Tjuur/G2P2_pochoco_soc/asic/reports/layout/pin_coordinates.csv

pin | direction | use | x_um | y_um | orientation
VDD | INOUT | POWER | 484.96 | 951.41 | N
VSS | INOUT | GROUND | 484.96 | 954.71 | N
i_Clk | INPUT | SIGNAL | 970.045 | 27.16 | N
i_Reset_n | INPUT | SIGNAL | 892.92 | 987.965 | N
i_SPI_CS_n | INPUT | SIGNAL | 970.045 | 675.64 | N
i_SPI_MOSI | INPUT | SIGNAL | 970.045 | 663.32 | N
i_SPI_SCLK | INPUT | SIGNAL | 970.045 | 676.76 | N
i_Switch[0] | INPUT | SIGNAL | 970.045 | 625.24 | N
i_Switch[1] | INPUT | SIGNAL | 970.045 | 631.96 | N
i_Switch[2] | INPUT | SIGNAL | 970.045 | 630.84 | N
i_Switch[3] | INPUT | SIGNAL | 970.045 | 609.56 | N
o_LED[0] | OUTPUT | SIGNAL | 970.045 | 626.36 | N
o_LED[1] | OUTPUT | SIGNAL | 970.045 | 629.72 | N
o_LED[2] | OUTPUT | SIGNAL | 970.045 | 628.6 | N
o_LED[3] | OUTPUT | SIGNAL | 970.045 | 627.48 | N
o_SPI_MISO | OUTPUT | SIGNAL | 970.045 | 664.44 | N
o_Segment1_A | OUTPUT | SIGNAL | 970.045 | 634.2 | N
o_Segment1_B | OUTPUT | SIGNAL | 970.045 | 637.56 | N
o_Segment1_C | OUTPUT | SIGNAL | 970.045 | 640.92 | N
o_Segment1_D | OUTPUT | SIGNAL | 970.045 | 636.44 | N
o_Segment1_E | OUTPUT | SIGNAL | 970.045 | 639.8 | N
o_Segment1_F | OUTPUT | SIGNAL | 970.045 | 635.32 | N
o_Segment1_G | OUTPUT | SIGNAL | 970.045 | 638.68 | N
o_Segment2_A | OUTPUT | SIGNAL | 970.045 | 665.56 | N
o_Segment2_B | OUTPUT | SIGNAL | 970.045 | 667.8 | N
o_Segment2_C | OUTPUT | SIGNAL | 970.045 | 671.16 | N
o_Segment2_D | OUTPUT | SIGNAL | 970.045 | 666.68 | N
o_Segment2_E | OUTPUT | SIGNAL | 970.045 | 672.28 | N
o_Segment2_F | OUTPUT | SIGNAL | 970.045 | 668.92 | N
o_Segment2_G | OUTPUT | SIGNAL | 970.045 | 670.04 | N
