Tjuur/G2P2_pochoco_soc/asic/reports/layout/register_file_coordinates.csv

instance | signal | x_um | y_um
_18060_ | \u_pochoco.u_core.u_rf.registers[1][0] | 407.12 | 678.16
_18061_ | \u_pochoco.u_core.u_rf.registers[1][1] | 467.6 | 721.28
_18062_ | \u_pochoco.u_core.u_rf.registers[1][2] | 374.64 | 638.96
_18063_ | \u_pochoco.u_core.u_rf.registers[1][3] | 464.24 | 658.56
_18064_ | \u_pochoco.u_core.u_rf.registers[1][4] | 353.92 | 705.6
_18065_ | \u_pochoco.u_core.u_rf.registers[1][5] | 618.8 | 666.4
_18066_ | \u_pochoco.u_core.u_rf.registers[1][6] | 575.68 | 646.8
_18067_ | \u_pochoco.u_core.u_rf.registers[1][7] | 525.84 | 638.96
_18068_ | \u_pochoco.u_core.u_rf.registers[1][8] | 580.72 | 729.12
_18069_ | \u_pochoco.u_core.u_rf.registers[1][9] | 529.2 | 725.2
_18070_ | \u_pochoco.u_core.u_rf.registers[1][10] | 630.0 | 642.88
_18071_ | \u_pochoco.u_core.u_rf.registers[1][11] | 342.72 | 682.08
_18072_ | \u_pochoco.u_core.u_rf.registers[1][12] | 328.72 | 811.44
_18073_ | \u_pochoco.u_core.u_rf.registers[1][13] | 403.76 | 787.92
_18074_ | \u_pochoco.u_core.u_rf.registers[1][14] | 395.92 | 776.16
_18075_ | \u_pochoco.u_core.u_rf.registers[1][15] | 319.76 | 650.72
_18076_ | \u_pochoco.u_core.u_rf.registers[1][16] | 556.08 | 697.76
_18077_ | \u_pochoco.u_core.u_rf.registers[1][17] | 333.76 | 842.8
_18078_ | \u_pochoco.u_core.u_rf.registers[1][18] | 360.08 | 885.92
_18079_ | \u_pochoco.u_core.u_rf.registers[1][19] | 323.68 | 913.36
_18080_ | \u_pochoco.u_core.u_rf.registers[1][20] | 418.88 | 905.52
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
_18536_ | \u_pochoco.u_core.u_rf.registers[15][28] | 593.04 | 917.28
_18537_ | \u_pochoco.u_core.u_rf.registers[15][29] | 545.44 | 917.28
_18538_ | \u_pochoco.u_core.u_rf.registers[15][30] | 399.28 | 846.72
_18539_ | \u_pochoco.u_core.u_rf.registers[15][31] | 418.32 | 599.76
