Tjuur/G2P2_pochoco_soc/asic/reports/layout/register_file_distribution.png

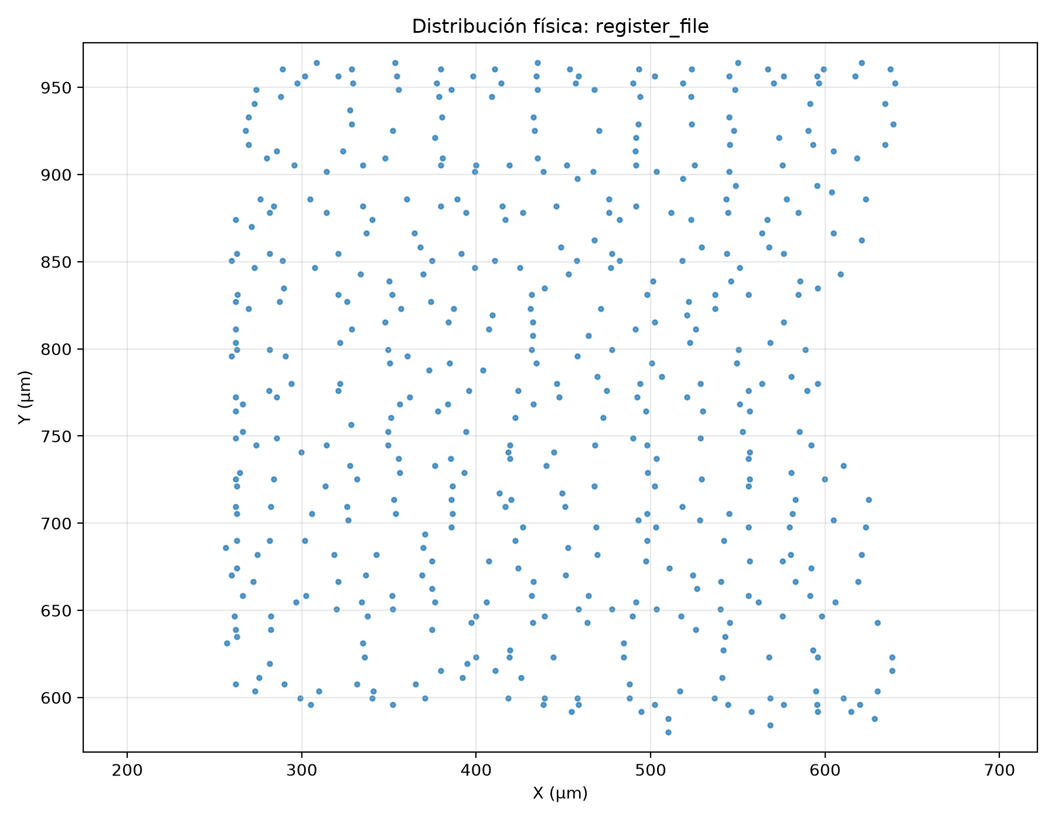
asic/reports/layout/register_file_distribution.png
