Tjuur/G2P2_pochoco_soc/asic/reports/utilization/utilization_vs_cost.png

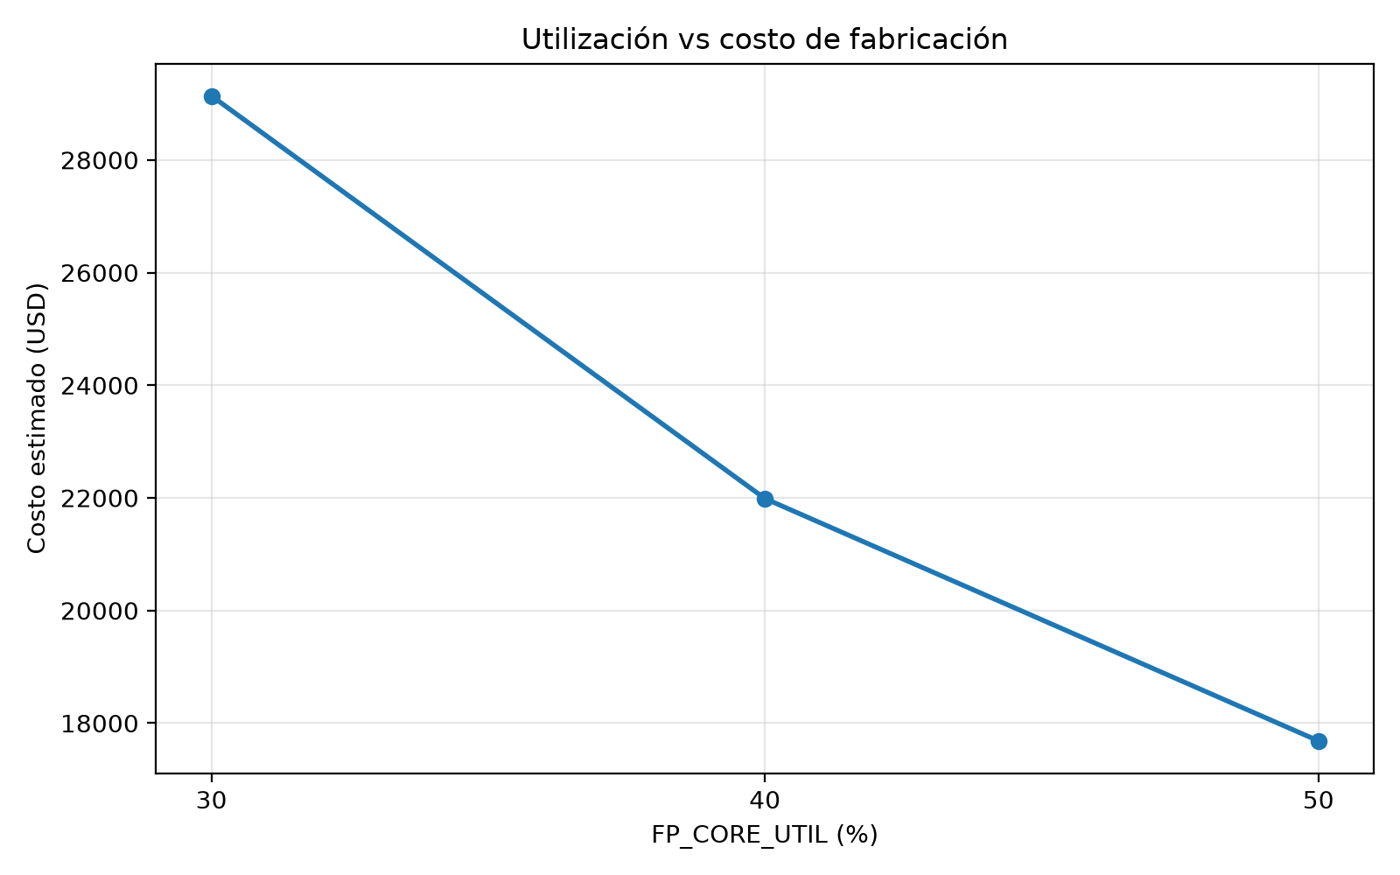
asic/reports/utilization/utilization_vs_cost.png
